Mthanson1/bomu-ieee-sscs/docs/main.pdf

# BoMu: A Resistively-Loaded NMOS Differential Pair Design & Sizing (SKY130A, TinyTapeout)

Mathew Hanson

October 2026

## 1 Introduction

BoMu is a single-stage differential amplifier built from a resistively-loaded NMOS source-coupled pair, designed for the SKY130A PDK and open-source TinyTapeout flow. Two matched NMOS devices (M1, M2) share a tail sink of 2ID, and each drain is pulled to the 1.2V supply through a load resistor RD. The amplifier output is taken differentially across the drains, vod = v(voutp) − v(voutn). A floating differential source ±vsd/2 on a common-mode VSC drives the gates through 100Ω series resistors.
The driving bandwidth constraint is that each output drives an I/O pad of fixed CL = 5pF. The tail sink is realised on-chip as a simple current mirror (Section 8.8) with a 200mV compliance budget. The flow is fully open-source (xschem, ngspice, magic/klayout); devices are sized by a gm/ID methodology [1] from measured current-density and speed data rather than an assumed square-law constant, and the small-signal results are standard [2].
This report documents the adopted W = 80 µm design and signs it off at the tt corner (with the native device-mismatch Monte Carlo of Section 10). The design is placed explicitly on the gm/ID area–power trade (Sections 8.3–8.4), where it sits at the optimum of a power-weighted cost. The common-centroid magic layout is then drawn, closed LVS/DRC clean, and re-simulated against its extracted parasitics (Section 11), which confirms both targets survive the layout.

### 1.1 Net identities

With the sign convention M1 gate = vinp → drain = voutn, and M2 gate = vinn → drain = voutp, the differential output vod = v(voutp) − v(voutn) has positive gain with respect to the differential input vid = vinp − vinn. The two half-circuits are identical by matching, so the analysis is done on a single common-source half-circuit and the differential result follows directly.

## 2 Specifications

The target specifications, and recommended design parameters, are collected in Table 1.

Table 1: Design targets and recommended parameters.
Parameter | Value | Units
Small-signal bandwidth f−3dB | 150 | MHz
Differential DC gain Av0 | 10 | dB
Differential output swing vod | 400 | mVpp
Channel length L | 0.15 | µm
Supply VDD | 1.2 | V (fixed)
Pad load CL (each output) | 5 | pF (fixed)
Tail-sink compliance budget | 200 | mV (fixed)

## 3 First-Order Hand Design

The design proceeds as follows: the fixed pad capacitance and the bandwidth target set the load resistor, the gain target then sets the required transconductance, and a chosen inversion level (gm/ID) fixes the

bias current.

Load resistor from bandwidth. The dominant pole sits at the output node, formed by the load resistance working into the fixed CL. Ignoring the device output resistance for the moment,

RD =

1
2πf−3dBCL

=

1
2π(150MHz)(5pF) ≈ 212Ω. | (1)

Transconductance from gain. The differential (half-circuit) gain of a resistively-loaded pair is

Av0 = gm(RD∥ro)

ro≫RD −−−−−−→ gmRD. | (2)

With Av0 = 10dB = 3.162V/V and Eq. (1),

gm =

Av0
RD

=

3.162
212Ω ≈ 14.9mS. | (3)

Bias current from gm/ID. Choosing a moderate-inversion gm/ID = 15V⁻¹
(a balance of device area, ro, and speed at this minimum length) fixes the per-branch current and the tail current,

ID =

gm
(gm/ID)

=

14.9 mS
15
≈ 0.99mA, | Itail = 2ID ≈ 2mA. | (4)

Swing and headroom. A 400mVpp differential swing corresponds to a single-ended peak of vod/4 = 100mV about each drain’s DC level VD = VDD − IDRD ≈ 0.99 V . Two conditions must hold: the bias drop must be large enough to source the swing, IDRD > 100mV (IDRD ≈ 210mV is ample), and the device must remain saturated at the bottom of the swing, VD,min − (VS + Vov) > 0, where VS is the tail-node voltage held at or above the 200 mV compliance budget. Both are comfortably satisfied because RD is small and the supply headroom is large.

## 4 gm/ID Sizing Flow

Equations (1)–(3) fix RD and the required gm. The gm/ID method then turns the chosen inversion level into a physical width. A unit device is characterised over VGS at fixed (VSB, VDS) to build a lookup grid returning, for any gm/ID, the current density JD (=ID/W), the intrinsic gain gmro, and the transit frequency fT . The width then follows as

W =

ID
JD(gm/ID, VSB, VDS)
| . | (5)

This is implemented in sim/sizing.py (worksheet), which references the extern/sky130A-gmid lookup grid (a git submodule). The script takes a DESIGN dict (targets + the two free knobs, gm/ID and VS), prints the worksheet of Table 2, and with --spice generates a differential-pair deck, runs ngspice, and reports predicted-versus-SPICE side by side (Table 3).

Table 2: Sizing worksheet at example operating point (gm/ID = 15, VS = 0.30 V , L = 0.15 µm, SKY130A nfet 01v8 lvt).
Quantity | Value | Units
RD (from BW) | 212 | Ω
gm required (from gain) | 14.9 | mS
ID / Itail | 0.99 / 1.99 | mA
Vov = 2/(gm/ID) | 0.133 | V
current density JD | 14.6 | µA/µm
width W (per device) | 68.0 | µm
output resistance ro | 941 | Ω
intrinsic gain gmro | 14.0 | —
transit frequency fT | 51.3 | GHz
bias nodes VD / VDS | 0.989 / 0.689 | V
power VDD ·Itail | 2.38 | mW

## 5 The ro-Limited Gain

Equation (2) assumed ro ≫ RD, but at minimum length this does not hold. The lookup returns ro ≈ 941Ω at gm/ID = 15, so the effective load is

RL = RD∥ro = 212∥941 ≈ 173Ω, | (6)

and the realised gain and bandwidth become

Av0 = gmRL ≈ 2.58 V/V (8.23dB), f−3dB =

1
2πRLCL
≈ 184MHz. | (7)

Because RD is pinned at 212 Ω by the fixed CL and the bandwidth target (Eq. (1)), and ro at this length is comparable to RD, the gain + BW targets are competing: the finite ro pulls the gain down to ∼ 8.2dB while pushing the bandwidth up past 150MHz. A single resistively-loaded stage at L = 0.15µm cannot simultaneously meet 10dB and 150MHz for the selected RD at the baseline current.
Figure 1 shows this: sweeping the inversion level with gm held at the gain-target value (14.9 mS), the realised gain plateaus near 8.3dB and never reaches 10 dB. At L = 0.15 µm the intrinsic gmro is simply too small for ro to dominate RD, regardless of bias. The resolution (Section 8.6) is a small increase in gm — i.e. a little more current — which lifts the realised gain–bandwidth product enough to clear both targets.


Figure 1: Gain and bandwidth versus inversion level gm/ID, with gm fixed at 14.9mS and RD = 212Ω. The gain plateaus near 8.3dB.

## 6 SPICE Verification (SKY130A, tt corner)

The self-contained differential AC testbench sim/tb ac.spice (floating ±vsd/2 drive, 100Ω gate resistors, on-chip 2ID tail mirror, 5pF pad caps) exercises the design under ngspice with the SKY130A tt models. The hand-calculations track SPICE closely as shown in Table 3. Particularly, the RD∥ro gain estimate of Section 5 reproduces the simulated gain to within 0.01dB, confirming the ro-limited result is real.

Table 3: Predicted (hand-calc) versus SPICE at the baseline sized operating point (W = 68µm, gm/ID = 15).
Quantity | Predicted | SPICE | Units
Tail current Itail | 1987 | 1987 | µA
gm per device | 14.9 | 14.85 | mS
Tail-node voltage VS | 0.30 | 0.205 | V
Differential gain Av0 | 8.23 | 8.24 | dB
Bandwidth f−3dB | 183.8 | 177.8 | MHz

The simulated response (Figure 2) is a flat ∼ 8.2dB passband rolling off at the single output pole, below the 10dB gain target and above the 150MHz bandwidth target — the ro-limited baseline that the gainrecovery of Section 8.6 corrects. The one row that does not track is the tail-node voltage VS (0.30V predicted vs. 0.205V in SPICE). This is expected: the 0.30V is not a prediction but the input knob fed to the gm/ID grid — the assumed source/body bias VSB at which the unit device was characterised (Table 2) — whereas the realised tail node is set by the input common mode and the pair’s actual VGS, and settles at 205mV (just above the 200mV compliance budget). The ∼ 95mV gap does not propagate into the sizing because W is taken from the current density JD, which depends only weakly on VSB; this is why gm, gain and bandwidth still match to within a percent despite it. The drain DC operating point of 0.988V matches VDD − IDRD exactly.


Figure 2: Differential AC response from sim/tb ac.spice (SKY130A, tt, baseline W = 68µm).

## 7 Design Bookkeeping: Predicted vs. SPICE Across the Flow

Table 3 spot-checked five quantities; this section carries the entire gm/ID sizing flow as a single Murmannstyle design-cockpit table (Table 4), each row quoting the hand/grid prediction against SPICE with a percentage error, at the baseline W = 68µm sizing point the method produces. The table is generated directly by sim/sizing.py cockpit (console) and --latex (this tabular), so it stays in sync with the sizing script. Of the sixteen rows carried predicted-vs-SPICE the mean absolute error is 1.1% and the worst is 6.5%.

Table 4: Design-cockpit bookkeeping at the baseline sized operating point (W = 68µm, gm/ID = 15, tt, 1.2V , 27◦C). Generated by sim/sizing.py cockpit --latex.

Parameter | gm/ID pred. | SPICE | %err | note
RD [Ω] | 212.2 | – | – | set by BW & C L (ideal load)
gm/ID [1/V] | 15 | 14.95 | -0.3 | inversion level (chosen)
ID/branch [µA] | 993.5 | 993.5 | +0.0 | gm req/(gm/Id)
Itail [mA] | 1.987 | 1.987 | +0.0 | = 2*Id (VDD current)
Vov [mV] | 133.3 | 142 | +6.5 | 2/(gm/Id) vs Vgs-Vth
JD [µA/µm] | 14.61 | 14.61 | +0.0 | current density (grid)
W [µm] | 68.02 | – | – | = Id/Jd (then rounded)
gm/device [mS] | 14.9 | 14.85 | -0.3 | = Av0/R D (ideal)
ro [kΩ] | 0.9415 | 0.9598 | +1.9 | output resistance
gmro [V/V] | 14.03 | 14.25 | +1.6 | intrinsic gain
fT [GHz] | 51.32 | 51.03 | -0.6 | = gm/(2pi.Cgg)
Cgg [fF] | 46.21 | 46.32 | +0.2 | gate cap
RL=RD∥ro [Ω] | 173.2 | 173.8 | +0.4 | real load
Av0 [dB] | 8.234 | 8.235 | +0.0 | = gm.R L
f−3dB [MHz] | 183.8 | 177.8 | -3.3 | = 1/(2pi.R L.C L)
GBW [MHz] | 474.3 | 458.9 | -3.2 | gain-bandwidth
Ptot [mW] | 2.384 | 2.384 | +0.0 | = VDD.I tail
VD (drain) [V] | 0.9892 | 0.9892 | -0.0 | drain DC
Vtail [V] | – | 0.2047 | – | ideal tail src; ≥0.2 V compliance met
SE swing peak [mV] | 100 | – | – | = v od/4 (headroom check)

The table shows two things. The current-domain rows (the grid density JD, hence W, and ID, gm, fT , Cgg, ro, gmro) all land inside 2%: the gm/ID grid predicts the sized device from the targets with essentially no iteration. The one visible gap is Vov (+6.5%): the Vov ≈ 2/(gm/ID) rule-of-thumb underestimates the true overdrive in moderate inversion, but because W is taken from the grid current density JD (not from Vov), that approximation does not propagate into the sizing. The cockpit is carried at W = 68µm rather than the adopted W = 80µm deliberately: this is the point the sizing flow produces directly from the targets, with no hand adjustment, so the predicted-vs-SPICE error isolates the accuracy of the gm/ID grid itself. The adopted design differs only by the deliberate GBW-wall and parasitic current margin of Sections 8.6–8.7 (and a re-centred RD), which are design choices, not predictions; rerunning the cockpit there would reproduce the same current-domain errors — the grid accuracy is independent of the sizing point — offset by that known margin, so it would add nothing about the method. The output rows then confirm the baseline sits where the flow places it — Av0 = 8.2 dB and f−3dB = 184 MHz — i.e. comfortably past the bandwidth target but short of the 10 dB gain, the ro-limited shortfall of Section 5 that the small gm increase of Section 8.6 then recovers to reach the adopted W = 80µm design.

## 8 Design-Space Sweeps and the Gain–Bandwidth Limit

Section 5 showed that at the chosen RD = 212Ω, the finite ro leaves the gain short and the bandwidth long. This section sweeps RD and L to map the achievable space.

### 8.1 RD: trading gain for bandwidth at constant gm/(2πCL)

For a single output pole the gain–bandwidth product is

Av0 · f−3dB = gm(RD∥ro) ·

1
2π(RD∥ro)CL

=

gm
2πCL
, | (8)

With gm = 14.9mS and CL = 5pF this ideal product is 474MHz. Sweeping RD (Figure 3) therefore slides the design along this fixed hyperbola. A larger RD buys gain at the cost of bandwidth. This sweep is at constant power, since RD draws no bias current. It is also, by itself, not a route to the gain target: once the two targets pin the product, no RD clears both at the baseline gm (quantified in Section 8.5).


Figure 3: RD sweep (iso-power 2.38mW): gain rises and bandwidth falls along the constant gm/(2πCL) product. Dotted lines mark the 10dB and 150MHz targets.

Channel length was also swept in an attempt to recover additional gain. Longer L raises ro, so RD∥ro → RD and the gain climbs toward the ideal gmRD at constant power (the current is unchanged, W ∝ L to hold the inversion level). The recovery is modest and saturating: 8.2dB at L = 0.15µm up to only ≈ 9.1dB by L = 0.6µm, which was still short of the 10dB target confirming the ro-limited ceiling of Section 5. Length trades area for a fraction of the missing gain but does not, on its own, reach the target.

### 8.2 The design space: bandwidth versus power at fixed gain and swing

The RD sweep moved along one iso-power hyperbola; the next question is how much bandwidth is available once power is allowed to vary, subject to the fixed 10dB gain and 400mV pp swing. For the single output pole, eliminating the load between Av0 = gm(RD∥ro) and f−3dB = 1/(2π(RD∥ro)CL) gives the load-independent relation

f−3dB =

gm
2πAv0CL

=

(gm/ID) ID
2πAv0CL
, | (9)

so at fixed Av0 and the fixed 5pF pad the bandwidth is set only by gm. Since P = VDD Itail = 2VDDID, bandwidth therefore scales linearly with power, and the slope of that line is the gm/ID efficiency. Figure 4 maps this plane: each line is one inversion level, swept over current.


Figure 4: Design-space frontier: achievable f−3dB versus power at fixed 10dB gain and 400mV pp swing, one line per gm/ID (slope ∝ gm/ID). Dashed segments are infeasible; the gold star is the adopted W = 80µm design on the gm/ID = 15 ray (2.74mW, 10.1dB, 168MHz).

Note first that feasibility is essentially current-independent: the headroom and swing walls are conditions on gm/ID, not on power, so each inversion level is feasible (or not) across the whole power axis. The nominal feasible window is wide, gm/ID ≈ 9 to 41: below ≈ 9 the drain headroom fails (the overdrive is large and, with gmro low, the gain-setting RD grows large enough to collapse the drain), and above ≈ 41 the RD drop falls below the 100mV single-ended swing. Within that window the only way to raise bandwidth at fixed power is to raise gm/ID: at the 2.38mW baseline, moving from gm/ID = 15 (150MHz) up toward the swing wall would, on paper, reach ∼ 380MHz at the same power.
That wide window is misleading, though. BoMu holds a moderate gm/ID = 15 (Vov ≈ 130mV ) rather than chasing the swing wall for robustness: a higher gm/ID means a smaller Vov and less gmro margin, so the stage becomes progressively more sensitive to the device spread the sizing is supposed to tolerate, and the moderate inversion keeps that headroom. The practical lever for more bandwidth is therefore power (the slope of Eq. (9)), not a freer inversion level — and, symmetrically, the only way to cut power at these specs is to cut gm, which gives back bandwidth one-for-one.

Where the design sits, and the minimum it costs. Figure 5 recasts the same plane with gain on the vertical axis, which makes the hard-target minimum explicit. With 150MHz pinning the load at RL ≤ 212Ω, the gain at the bandwidth edge is Av0 = gmRL = (gm/ID) ID · 212Ω, so each inversion level is a ray rising with power (slope ∝ gm/ID) until it saturates at the gmro ceiling. The power at which a ray crosses 10dB is the ideal minimum to meet both targets at that gm/ID — ideal because it assumes the realised gain–bandwidth product equals the single-pole gm/(2πCL) of Eq. (8). On the gm/ID = 15 ray adopted here that ideal floor is 2.38mW. It is not reachable in practice: as Section 8.5 shows, second-order gate/Miller poles pull the realised product ∼ 1.5% short, so the baseline at this power misses both targets by a few percent. The adopted W = 80µm design therefore sits above the ideal floor at 2.74mW once that gain-bandwidth-wall and the parasitic margin (Sections 8.6–8.7) are added. Spending more power moves the design up its ray (more gain/BW margin) and spending less moves it down toward the infeasible region — the adopted point is a deliberately small step above the ideal floor.

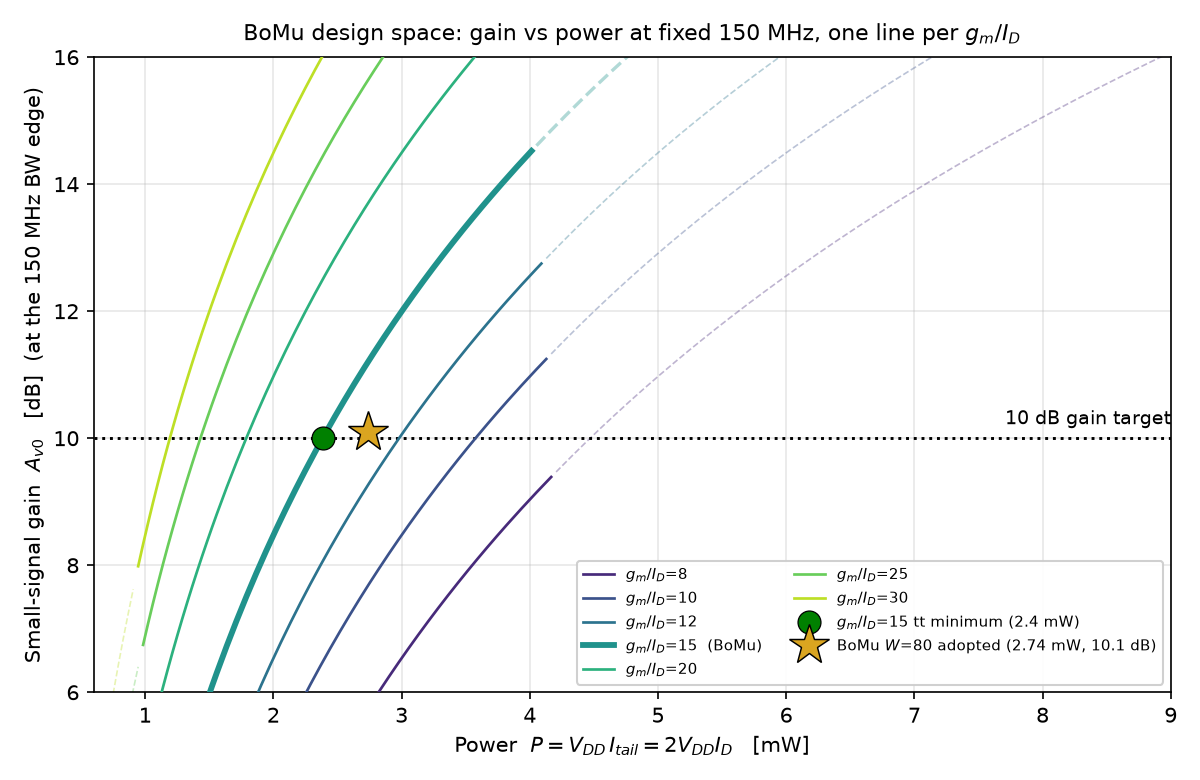
[picture p9: figure]

Figure 5: Gain versus power at the fixed 150MHz edge, one line per gm/ID. On the gm/ID = 15 ray the 10dB target has an ideal (single-pole) floor of 2.38mW (green circle); the realised design clears both targets a step above it, at the adopted W = 80µm point (2.74mW). Generated by sim/plot gain space.py.

### 8.3 The area–power plane: where each gm/ID ray sits

The bandwidth- and gain-versus-power views priced each inversion level in power ; the third axis that matters on a fixed TinyTapeout tile is area. This subsection adds it, so the inversion level can be chosen on the full area–power trade before the operating current on the ray is fixed (Sections 8.5–8.7).
Figure 6 projects the 10dB/150MHz tt criteria onto the area–power plane, one ray per inversion level, in the same house style as the bandwidth- and gain-versus-power frontiers of Section 8.2. At fixed gm/ID the pair gate area is linear in power,

2W L = 2L

ID
JD

=

L

VDD

P
JD(gm/ID)
, | (10)

so each gm/ID is a ray from the origin whose slope ∝ 1/JD steepens with inversion level (weak inversion spends area fast). The 10dB/150MHz spec needs a minimum gm, hence a minimum current, so each ray is spec-feasible only above an onset power (solid above, dashed below); the locus of those onsets is the tt frontier. Along it, strong inversion (low gm/ID) gives small area but high power, weak inversion the reverse — area and power trade against each other, bounded below by the drain-headroom wall and above by the output-swing wall of Section 8.2.


Figure 6: Area–power plane: pair gate area 2W L versus power to meet 10dB/150MHz at tt, one ray per gm/ID (solid where spec-feasible, dashed below the onset marker). The adopted W = 80µm design (gold star, 2.74mW, 24µm²
) sits on the gm/ID = 15 ray, just above its ideal (single-pole) onset minimum (green circle, 2.38mW, 21µm²
). Generated by sim/plot area power.py.

The eventual operating point (gold star — the W = 80µm design fixed in Sections 8.6–8.7) will sit at the lower-left of this plane, near the minimum area and minimum power the tt criteria allow at a conservative moderate inversion, on the gm/ID = 15 ray, a small step above its feasibility onset. Whether gm/ID = 15 is itself the right ray to be on is settled in the next subsection with a scalar cost.

### 8.4 The gm/ID optimum: a power-weighted cost

Each gm/ID ray in Figure 6 meets the spec at a different (area, power) pair, so choosing the inversion level is choosing a point on the area–power frontier. To collapse that two-dimensional trade to a single preference we score each feasible ray with a scalar cost and ask which gm/ID minimises it (Figure 7).

Equal weighting is nearly flat. The scale-free equal-weight product Pmin ·A gives the shallow grey bowl of Figure 7, minimised at gm/ID ≈ 12 but very weakly defined (the band gm/ID ≈ 10–15 is within +10%). The flatness is structural: near the square-law limit JD ∝ V

2
ov and gm/ID ∝ 1/Vov,
so P ·A ∝ 1/
(gm/ID)

2JD

is nearly constant — power and area trade almost reciprocally, and their product barely discriminates. The tilt that remains comes from the ro-gain wall inflating power below the bowl and JD collapsing (area diverging) above it.

Power-weighting selects gm/ID = 15. Equal weighting is the wrong model here: it prices a µm² and a mW the same, whereas on a fixed TinyTapeout tile area is effectively free and power is the real budget. Valuing power roughly twice the area — the scale-free weighted product C = P

0.66A⁰.33 — pulls
the optimum up in gm/ID (toward lower power), from 12 to ≈ 15 (black curve). The same shift lands at gm/ID = 15.0 under a normalised weighted sum 0.66 Pˆ + 0.33 Aˆ, so the result is not an artifact of the sum-versus-product choice. BoMu’s gm/ID = 15 is therefore the optimum of this power-weighted cost, and the adopted W = 80µm design sits on that ray.

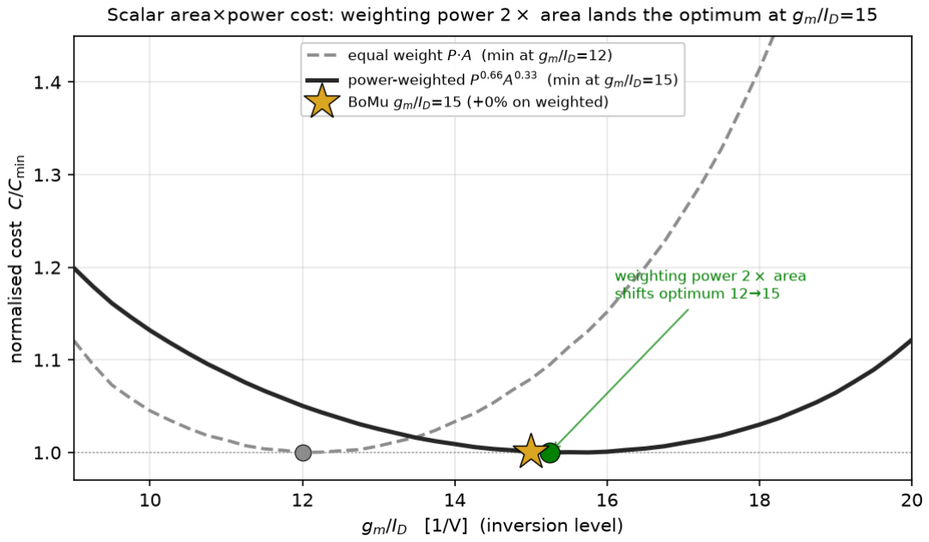
[picture p10: figure]

Figure 7: Scalar cost of the area–power trade along the tt frontier, each curve normalised to its own minimum. Equal weight P·A (grey dashed) minimises at gm/ID ≈ 12; power-weighted P

0.66A⁰.33 (black)
shifts the optimum to gm/ID ≈ 15, BoMu’s choice (star). Generated by sim/plot area power.py.

Two qualifications are worth stating. The 0.66/0.33 weights are a design choice (power-limited tile), not a derivation; a different valuation moves the optimum, and the bowl is shallow enough that anything in gm/ID ≈ 13–17 is near-equivalent, so the cost function corroborates gm/ID = 15 under a reasonable power-first weighting rather than uniquely forcing it. Independently, a moderate gm/ID also carries the larger Vov and gmro headroom that makes the stage tolerant of device spread (Section 8.2), so the power-weighted cost optimum and the robustness-preferred value coincide at 15.

### 8.5 Sizing the current on the ray: is RD ≈ 280 Ω enough?

With gm/ID = 15 fixed as the cost-optimal ray, the remaining freedom is the operating current on it. The baseline sizing (Section 6: W = 68µm, Itail = 1.99mA) sits at the bottom of that ray; this subsection confirms it cannot reach both targets by re-tuning RD alone, which motivates the small current increase of Section 8.6. The two targets have product 3.162×150MHz = 474MHz, which is exactly the ideal GBW of Eq. (8). The specification therefore sits right on the single-stage limit, reachable only if the realised product equals the ideal. It does not: second-order gate/Miller poles pull the SPICE gain–bandwidth product down to ≈ 467MHz, about 1.5% short. Table 5 brackets RD in SPICE (tt, L = 0.15, W = 68); note no value of RD has sufficient GBW product at the baseline gm.

Table 5: RD bracket in SPICE.
RD [Ω] | Av0 [dB] | f−3dB [MHz] | GBW [MHz]
220 | 8.49 | 175.8 | 468
250 | 9.37 | 158.7 | 467
265 | 9.76 | 151.7 | 467
280 | 10.13 | 145.4 | 467
300 | 10.58 | 137.9 | 466

So RD ≈ 280Ω is a close but still not a feasible solution: the gain passes (10.13dB) but the bandwidth is 145MHz (∼ 3% low). Moving to RD = 265Ω recovers bandwidth to 152MHz but drops the gain to 9.76dB. The Av0 = 10dB crossover lands at RD ≈ 277Ω with only f−3dB ≈ 148MHz. The design lands within ∼ 2–3% of both but meets neither pair simultaneously, with no margin. Closing the last few percent requires more GBW, which Eq. (8) says comes from a slightly higher gm (a little more current/power).

### 8.6 Meeting both specs: a small gm increase

Because the realised GBW scales with gm (Eq. (8)), the ∼ 1.5% shortfall is closed by a comparably small increase in gm. Holding gm/ID = 15 and L = 0.15µm, raising gm from 14.9 to 16.0mS (widening the pair and the tail current) lifts the realised gain–bandwidth product to ≈ 500MHz, clearing the 474MHz the pair requires. Re-centring the load then lands both targets with margin (Table 6).

Table 6: Closing the GBW gap with a gm increase, SPICE tt, L = 0.15µm, gm/ID = 15 (ideal tail sink).
gm [mS] | W [µm] | RD [Ω] | Av0 [dB] | f−3dB [MHz] | P [mW]
14.9 (base) | 68 | 212 | 8.24 | 178.0 | 2.38
15.6 | 71 | 272 | 10.23 | 150.2 | 2.50
16.0 | 73 | 262 | 10.15 | 155.5 | 2.56
16.0 | 73 | 272 | 10.40 | 151.1 | 2.56

The rows above cross the targets near gm = 16mS (W ≈ 73µm), but the margins there (+0.15dB, +5.5MHz) are thin. A small additional current buys headroom against the layout parasitics that Section 8.7 addresses, fixing the final operating point.

### 8.7 Layout-parasitic headroom and the adopted operating point

The gm ≈16mS point only marginally clears the bandwidth target, and layout will add output-node capacitance (drain-junction Cdb plus pad interconnect) on top of the fixed 5pF. Since f−3dB = 1/(2πRLCtot) falls with total capacitance while the DC gain gmRL is unaffected (a capacitance is an open circuit at DC and carries no bias current), only the bandwidth spec is exposed to parasitics. The remedy is a small current margin: widening the pair to W = 80µm (Itail = 2.28mA) on the RD ≈ 245Ω load lifts the nominal bandwidth well past target with the gain comfortably over 10dB. At this point the measured response (real res high po loads and mirror, tt) is

Av0 = 10.1 dB, | f−3dB = 168 MHz, | P = 2.74 mW, | (11)

so the bandwidth carries ∼ 12% of headroom over 150MHz — enough to absorb the few-percent capacitive pole shift a compact layout adds while the gain, which parasitics do not touch, holds its ∼ 0.1dB margin. This is the adopted design; its sizing is summarised in Table 7.

Table 7: Adopted W = 80µm sizing (ip/bomu.sch).
Device | Sizing | Role
M1, M2 (pair) | nfet 01v8 lvt W=80 µm, L=0.15, nf=8 | input diff pair
RD1, RD2 | res high po 5p73 L=3.1 µm (≈ 243 Ω) | drain loads
M3 (mirror out) | nfet 01v8 W=80 µm, L=0.5, nf=8 | tail sink (N=8)
M4 (mirror ref) | nfet 01v8 W=10 µm, L=0.5, nf=1 | diode reference
Rref | res high po 2p85 L=5.41 µm (≈ 745 Ω) | Itail program
Itail | 2.28 mA (VSC = 1.052 V ) | —

### 8.8 Tail-current mirror and input common-mode

The ideal tail sink is realised on-chip as a simple two-transistor resistor-programmed NMOS mirror, kept fully internal. A cascode/Wilson mirror needs VGS + VDS,sat ≳ 0.5V of compliance, far above the tail budget, so only a simple mirror fits. A raised input common-mode VSC = 1.052V lifts the tail node to ≈ 0.33V , putting the mirror in clean saturation while the pair retains abundant drain headroom. The 400mVpp swing survives (lowest single-ended output 0.82V , still well above the saturation floor; Section 9).
The mirror uses standard-VT nfet 01v8 devices at L = 0.5µm: output M3 = W80µm/nf8, reference M4 = W10µm/nf1, ratio N = 8, so the reference leg draws only Itail/8 ≈ 0.285mA through Rref ≈ 745Ω from VDD. An integrated AC simulation (sim/tb ac.spice) with the real mirror replacing the ideal sink closes the operating point and leaves the differential spec essentially untouched (Table 8): at Rref = 745Ω the tail settles at 0.333V , Itail = 2.28mA, Av0 = 10.19dB, f−3dB = 167MHz (ideal RD; the real res high po load trims this to the 10.1dB/168MHz of Section 8.7). The gain degrades by only ∼ 0.03dB from the ideal source, as the mirror’s finite rout lands on the common-mode path, not the differential one. The programming resistor sets Itail, so Rref is the single knob for the gain/BW trim. The mirror is folded into ip/bomu.sch (M3/M4, Rref ); the complete schematic — pair, dummy-flanked loads and tail mirror — is shown in Figure 8.

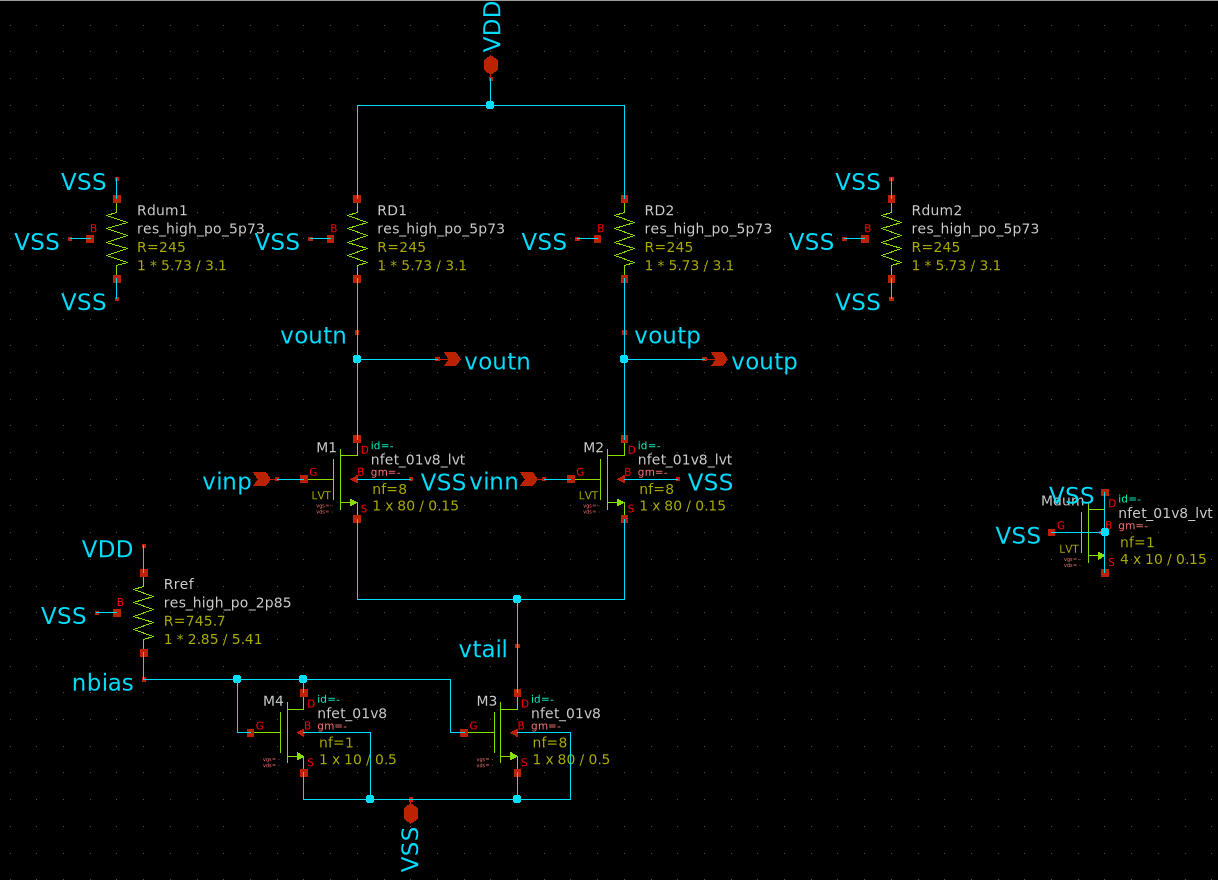
[picture p11: figure]

Figure 8: The adopted W = 80µm BoMu schematic ip/bomu.sch: M1/M2 pair, res high po drain loads RD1/RD2, and the resistor-programmed N=8 tail mirror (M3/M4, Rref ).

Table 8: Integrated AC verification (sim/tb ac.spice): BoMu with the real tail mirror (Wout = 80, Wref = 10, L = 0.5, N = 8), sweeping the programming resistor. W = 80µm pair, ideal RD = 245Ω, VSC = 1.052V .

Rref [Ω] | Vtail [V] | Itail [mA] | Av0 [dB] | f−3dB [MHz]
720 | 0.332 | 2.32 | 10.26 | 167.8
745 | 0.333 | 2.28 | 10.19 | 167.3
760 | 0.334 | 2.26 | 10.15 | 167.1

## 9 Large-Signal Swing and Distortion

The 400mVpp differential output swing (Table 1) is a large-signal requirement, so it is checked with a dedicated transient testbench (ip/tb bomu swing.sch, Figure 9, which instantiates the bomu.sym symbol hierarchically). A differential 1MHz sine rides on the VSC = 1.052V input common mode with persource amplitude Va = 32mV , so vid,pp = 4Va = 128mVpp drives the amplifier to the swing target. At the tt corner (1.2V , 27◦C) the measured swing is vod,pp = 400mVpp, on target, with each single-ended output spanning 0.824–1.024V about a ∼ 0.924V common mode — inside the rails with every device still saturated, so the stage is not clipping. The same deck reports the AC gain/bandwidth and the averaged supply power (Av0 = 10.1dB, f−3dB = 168MHz, 2.74mW pair / 3.10mW total including the reference leg), so swing, gain, bandwidth and power all come from one run.


Figure 9: The transient swing testbench ip/tb bomu swing.sch.

Third-harmonic dominance. A Fourier decomposition of vod (fundamental 1MHz, ten harmonics) gives THD = 0.61%, set almost entirely by the third harmonic (Table 9). Two features are characteristic of a balanced source-coupled pair. First, the even harmonics vanish (at the ∼ 10⁻¹⁴ numerical floor): even-order distortion is common-mode and cancels in vod = v(voutp)−v(voutn), so their absence confirms the devices and loads are symmetric. Second, the residual distortion is odd-order, led by the third. Both features follow from the shape of the balanced pair’s differential transfer iod(vid), independently of any particular device law: it is an odd function of the differential drive (swapping the inputs negates the output), which is precisely what forces the even harmonics to cancel, and it is compressive (the pair steers a fixed tail current, so iod saturates at ±Itail). An odd, compressive characteristic has a Taylor expansion in odd powers of vid alone, so the leading nonlinearity is the cubic term,¹ which folds back as a third harmonic. The fifth and higher harmonics fall off by orders of magnitude, hence THD ≈ the third-harmonic term alone. Because that term scales with the cube of the drive, distortion climbs quickly

1There is no closed-form expression for iod(vid) at BoMu’s operating point. The often-quoted iod ∝ tanh
vid/2nVT
is the weak-inversion limit only, where the devices follow the exponential law iD ∝ exp(vGS/nVT ) (VT = kT /q the thermal voltage, n the subthreshold slope factor, highest gm/ID); the opposite strong-inversion limit is the square-law
√
-characteristic. BoMu runs at gm/ID ≈ 15 (moderate inversion), between the two, where neither closed form holds — but the odd-symmetry and leading-cubic arguments above hold throughout.

with swing; at the 400mVpp operating point it stays a clean 0.61%.

Table 9: Fourier spectrum of vod at the 400mVpp operating point (tt, 1.2V , 27◦C, 1MHz drive).
Harmonic | Freq [MHz] | Norm. mag
1 | 1 | 1.000 | fundamental (0.201 V ampl.)
2 | 2 | 4 × 10⁻¹⁴ | even (cancelled)
3 | 3 | 6.1 × 10⁻³ | dominant (≈ THD)
4 | 4 | 5 × 10⁻¹⁴ | even (cancelled)
5 | 5 | 7.0 × 10⁻⁶

## 10 Small-Signal Quality: Offset, CMRR, PSRR and Noise

Beyond the headline gain/bandwidth/swing targets, the pair is characterized for input offset, common-mode and supply rejection, and noise, at tt/1.20V / 27◦C. These figures are measured on the extracted, post-layout netlist (verify/bomu rcx.spice, full R + C RCX of the signed-off W=80µm layout) via sim/corners.py acq rcx and sim/corners.py mc mm --pex rcx, so the numbers below carry the real device sizing and the layout parasitics. One point about the models frames every mismatch-dependent number. Contrary to a common belief about the open PDK, sky130A does carry native statistical device mismatch: the .pm3 model cards apply per-device Gaussian spread to Vth0, toxe, vof f and nfactor through mc mm switch·AGAUSS(. . .) terms, live in nfet 01v8 lvt (the pair), nfet 01v8 (the mirror) and res high po (the loads). Because the extracted .subckt wraps these same sky130 device instances, the native mismatch still redraws per device inside the parasitic netlist. The offset below is therefore drawn from this native mismatch with no assumed Pelgrom coefficient (mc mm switch flipped via alterparam after the .lib loads, then re-seeded per draw; see corners.py mc mm --pex).

Input offset. A 40-draw native-mismatch Monte Carlo on the extracted W=80µm pair (12µm² per device) gives σ(Vos) ≈ 2.8mV (3σ ≈ 8.3mV , worst draw 7.4mV ), centred on zero (mean +0.6mV ). Because offset grows as 1/

√
W L, this is set by the pair size the gain–bandwidth sizing already demands; it is modest by construction and protected by the common-centroid layout of Section 11 — indeed the extracted interdigitated pair sits a little below the ∼ 3.6mV a single lumped W=80µm device predicts. Offset is treated as a separate, un-targeted spec here.

CMRR and PSRR. Because the output is taken differentially between matched halves, common-mode input and supply ripple couple almost entirely into the output common mode and cancel differentially. The differential CMRR and PSRR are matching-limited, not tail-limited, and would be infinite for a perfectly symmetric netlist; over the native-mismatch draws on the extracted netlist their median is CMRR ≈ 67dB and PSRR ≈ 53dB (both scale inversely with the per-draw mismatch, so they are quoted as the median of the 24-draw set). The underlying common-mode paths set the ceiling and are finite: the tail-limited common-mode gain is Acc = −17.6dB, and because RD couples VDD straight onto each drain — now reinforced by the asymmetric VDD-to-drain coupling capacitors the extraction adds — the supply-to-common gain rises to Asc = −7.8dB. This is the same balance that suppressed the even harmonics in Section 9.

Noise. The input-referred noise of the extracted netlist integrated over 10Hz–1GHz is ≈ 93µVrms (device thermal/flicker dominated, so it is taken at the nominal matched point rather than per mismatch draw). Against the ∼ 45mVrms differential input drive that produces the 400mVpp output swing (the vid,pp = 4Va = 128mVpp at Va = 32mV of Section 9), this is an input SNR of order 54dB. The integration band runs well past the ∼ 164MHz output pole, so the figure is conservative: above the pole the falling gain inflates the input-referred density, and most of the integral accumulates beyond the usable band.

Table 10: Post-layout small-signal quality on the extracted netlist (verify/bomu rcx.spice) at tt/1.20V /27◦C. Input offset is a 40-draw native sky130A device-mismatch Monte Carlo (no assumed AV T ); the differential CMRR/PSRR are mismatch-limited and quoted as the median of a 24-draw set (they scale inversely with the per-draw mismatch). Noise is at the nominal matched point.
Metric | Value | Condition
Input offset σ(Vos) | ≈ 2.8 mV | native-mismatch MC (40 draws)
Input offset 3σ | ≈ 8.3 mV | native-mismatch MC (40 draws)
CMRR (differential) | ≈ 67 dB | native mismatch (median, 24 draws)
PSRR (differential) | ≈ 53 dB | native mismatch (median, 24 draws)
Common-mode gain Acc | −17.6 dB | tail-limited
Supply→CM gain Asc | −7.8 dB | RD + parasitic coupling
Input-referred noise | ≈ 93µVrms | 10Hz–1GHz, nominal

## 11 Physical Layout in magic

With the W = 80µm design signed off against the tt corner, the bomu cell is drawn in magic on SKY130A from the adopted schematic (Table 7), following the matching and isolation methodology below.

Pair core. The overriding layout concern for a differential pair is matching of M1/M2, so the core is a common-centroid interdigitation of the nf = 8 pair. The W = 80µm/nf = 8 pair lays out as 10µm-per-finger unit devices on isolated diffusion islands, assigned to the two halves in an alternating centroid pattern so a linear process gradient across the block cancels differentially.

Edge dummies. Matching is protected at the array edges by same-width nf = 1 dummy transistors on the left and right columns, which give the outermost live fingers an identical poly/diffusion neighbourhood (10µm finger width, matching the pair). Their gates, sources and drains are strapped to VSS. The load resistors are handled the same way: the two live loads RD1/RD2 (res high po 5p73) are flanked by two dummy resistors of identical geometry for etch/density symmetry, terminated to VSS.

Tail mirror and guard rings. The mirror lays out as a single interdigitated row of nfet 01v8 unit fingers (W = 10µm, L = 0.5µm) with the diode-connected reference M4 at the centre and the eight M3 output fingers around it (a 1-D common-centroid, ratio N = 8); the programming resistor Rref (res high po 2p85) sits beside it. Being an all-NMOS block, every sub-block is wrapped in a p⁺ guard ring tied to VSS with no n-well, and the six top-level ports (vinp, vinn, voutp, voutn, VDD, VSS) are brought out on upper metal past the outer ring. The finished cell is shown in Figure 10.

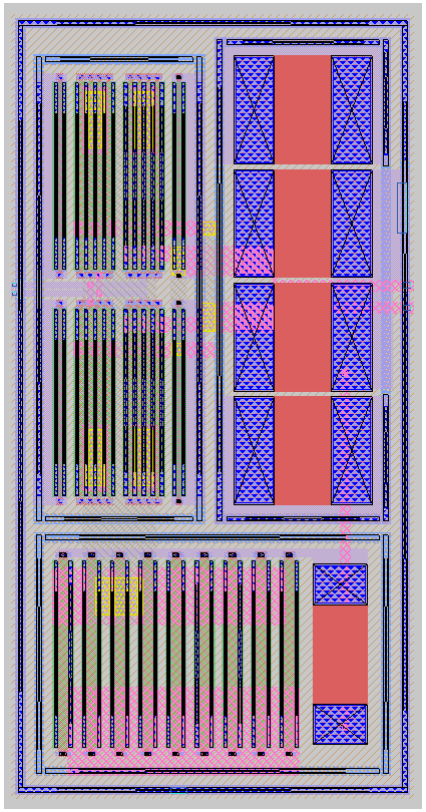
[picture p12: figure]

Figure 10: The signed-off bomu cell in magic (SKY130A): the common-centroid W = 80µm pair with edge dummies, the dummy-flanked res high po load bank, and the interdigitated tail mirror, each wrapped in a VSS-tied p⁺ guard ring.

Verification and sign-off. The block closes LVS (netgen against ip/bomu.sch) match uniquely, and both DRC decks — magic geometric and the klayout sky130A mr sign-off runset on the written GDS — report zero violations. Parasitics are then extracted (full R+C RCX via magic’s extresist) and the tt AC response re-run against the extracted netlist. Table 11 compares the schematic and post-layout operating point: as Section 8.7 anticipated, the parasitics load the output pole (a few-percent bandwidth shave) but leave the DC gain essentially untouched, and the ∼ 12% pre-layout bandwidth margin absorbs the shift — the extracted design still clears both the 10dB gain and 150MHz bandwidth targets.

Table 11: Adopted W = 80µm design: schematic vs. post-layout (RCX, full R + C) at the tt corner, 27◦C, VDD = 1.20V . Both specs (Av0 ≥ 10dB, f−3dB ≥ 150MHz) are met with parasitics.
Quantity | Schematic | Post-layout (RCX) | Unit
Differential gain Av0 | 10.1 | 10.19 | dB
Bandwidth f−3dB | 168 | 164.1 | MHz

The signed-off GDS and the LVS/DRC reports are archived under tapeout/ and verify/; the extraction and compare scripts are verify/ext rcx.tcl, verify/run lvs.sh and verify/drc.sh, and the post-layout corner sweep is sim/corners.py pex rcx.

## 12 Status and Next Steps

The sign-off cockpit for the adopted W = 80µm design — the block intended for tapeout — is collected below as a single-glance review summary of the targets, the tt performance (schematic and post-layout RCX), the small-signal quality and the physical-verification status. Every number is carried elsewhere in the document; this is the consolidated view. All performance figures are at the tt corner, VDD = 1.20V , 27◦C; the quality figures are on the extracted netlist (verify/bomu rcx.spice). The offset/CMR-R/PSRR figures come from sky130A native local device-mismatch Monte Carlo only — not a global process-corner MC, so they are a matching check, not a full statistical sign-off.

| Performance (tt; schematic → post-layout RCX). Differential DC gain Av0 = 10.1 → 10.19 dB (target ≥ 10 dB, ✓); bandwidth f−3dB = 168 → 164.1 MHz (target ≥ 150 MHz, ✓); output swing 400 mVpp at 0.61% THD (target 400 mVpp, ✓); power P = VDDItail = 2.74 mW (Itail = 2.28 mA).
| Operating point (ip/bomu.sch). Input pair M1, M2: nfet 01v8 lvt W=80µm/L=0.15/nf=8; drain loads RD: res high po ≈ 243 Ω; tail mirror N=8 at VSC = 1.052 V, Vtail = 0.333 V; inversion gm/ID = 15 V⁻¹ .
| Small-signal quality (RCX; native local device-mismatch MC). Input offset σ(Vos) ≈ 2.8 mV and 3σ(Vos) ≈ 8.3 mV (40-draw); CMRR ≈ 67 dB and PSRR ≈ 53 dB (differential, median of 24 draws); input-referred noise ≈ 93 µVrms (10Hz–1GHz).
| Physical verification. LVS (netgen) matches uniquely (✓); DRC zero violations on both the magic and klayout sky130A mr decks (✓); parasitics extracted full R+C RCX (✓).

The central result (Section 8) is that the 10dB / 150MHz specification sits on the single-stage gain– bandwidth wall gm/(2πCL), which the baseline sizing clears by only ∼ 1.5%. A small gm increase and a parasitic margin give the adopted W = 80µm design (RD ≈ 245Ω, Itail = 2.28mA, 2.74mW), which meets both targets at the tt corner — Av0 = 10.1dB, f−3dB = 168MHz, 400mVpp swing at 0.61% THD — and survives the native local device-mismatch MC (Section 10), which moves offset; the differential gain and bandwidth are expected to be left essentially unchanged by mismatch, since the common-mode and mismatch terms cancel in a balanced pair — though the draws were scored for offset and CMRR/PSRR, not for a gain/BW spread, so this is an expectation rather than a measured σ(Av0)/σ(f−3dB). This MC covers per-device mismatch only; it is not a global process-corner Monte Carlo, so it is not a full statistical sign-off — a global process-corner MC (with the full VDD/temperature grid) remains a future step. On the area–power plane (Sections 8.3–8.4) it sits near the joint minimum of area and power the tt criteria allow, on the gm/ID = 15 ray that is the optimum of a power-weighted cost.
The physical implementation (Section 11) is now complete and signed off: the W = 80µm common-centroid pair, the dummy-flanked load bank and the interdigitated tail mirror are drawn with VSS-tied guard rings, the block closes netgen LVS match uniquely and passes both the magic and klayout sky130A mr DRC decks with zero violations, and the extracted-parasitic (RCX) tt AC re-simulation confirms the ∼ 12% bandwidth margin absorbs the parasitic pole shift with the gain intact (Table 11). The signed-off GDS and reports are archived under tapeout/ and verify/.
The offset/CMRR/PSRR/noise characterisation of Section 10 is now run directly on the extracted (post-layout) netlist: the native device-mismatch Monte Carlo and the CMRR/PSRR/noise measurements all exercise verify/bomu rcx.spice, so they carry both the adopted W=80µm sizing and the layout parasitics. The headline differential gain/bandwidth are expected to be essentially untouched by mismatch (balanced-pair cancellation; the draws were not scored for their spread); the quality metrics land at σ(Vos) ≈ 2.8mV , CMRR ≈ 67dB, PSRR ≈ 53dB and ≈ 93µVrms input-referred noise, with the supply-rejection path the most parasitic-sensitive (Asc rising from the ideal RD-coupling estimate once the extracted VDD-to-drain capacitors are included).

Further improvements. Several directions would push the design past its current limits. (i) The headline constraint is the single-stage gain–bandwidth wall gm/(2πCL) (Section 8), and the analysis there is explicit that the only lever on that wall is more gm — bought either by spending more power (moving up a gm/ID ray) or by raising the gm/ID efficiency itself (a steeper ray, bounded above by the swing/headroom walls of Section 8.2). At fixed gain and swing the bandwidth scales linearly with power at a slope set by that gm/ID efficiency (Eq. (9)), and no load re-tuning escapes the 474MHz ideal product (Eq. (8), Table 5). Cascoding to raise ro would only slide the design along that hyperbola — more gain for less bandwidth — and still miss both targets at the baseline gm, so it is not a way around the wall. What a cascode can do, applied to the input pair rather than the load, is reduce the Miller multiplication of Cgd that forms the second-order gate pole — the pole Section 8.5 found pulls the realised GBW ∼ 1.5% below the 474MHz ideal. An input-pair cascode could recover part of that 1.5%, nudging the realised product toward the single-pole ideal rather than beating it, at the cost of the extra stacked VDS,sat the 1.2V rail and 400mVpp swing make scarce. (ii) Active-inductor peaking at the output pole would extend f−3dB at fixed RD and current; a passive spiral of the required value is far too large for the TinyTapeout tile, so only an active inductor (a gyrator-C load) is practical, buying bandwidth margin at the price of its own headroom and noise. (iii) The supply-rejection path is the weakest small-signal link (Asc = −7.8dB, Section 10, set by VDD coupling through RD onto the drains); a replica-biased or regulated drain load would attenuate that path and tighten the present PSRR ≈ 53dB (median of the 24-draw native-mismatch set). (iv) The simple tail mirror is compliance-limited (Section 8.8); a lowvoltage cascode or constant-gm tail would raise the tail output resistance — improving on the present CMRR ≈ 67dB (24-draw median) — and cut the supply/temperature sensitivity of Itail, if the 200mV budget can be relaxed or a cascode fitted within it. (v) If offset ever becomes a spec, chopping or auto-zeroing (or simply more pair area) would push below the present σ(Vos) ≈ 2.8mV (40-draw native-mismatch MC). None of these beats the gain–bandwidth wall — Section 8 shows only more gm per mW does that; they refine the realised design toward its ideal limit (input cascode), extend bandwidth (active inductor), or harden the rejection and offset the quality section measures.

## References

[1] P. G. A. Jespers and B. Murmann, Systematic Design of Analog CMOS Circuits Using Pre-Computed Lookup Tables. Cambridge University Press, 2017.
[2] B. Razavi, Design of Analog CMOS Integrated Circuits, 2nd ed. McGraw-Hill, 2017, ch. 4: Differential Amplifiers.
