Mthanson1/bomu-ieee-sscs/docs/Figures/bomu_sweep_L.png

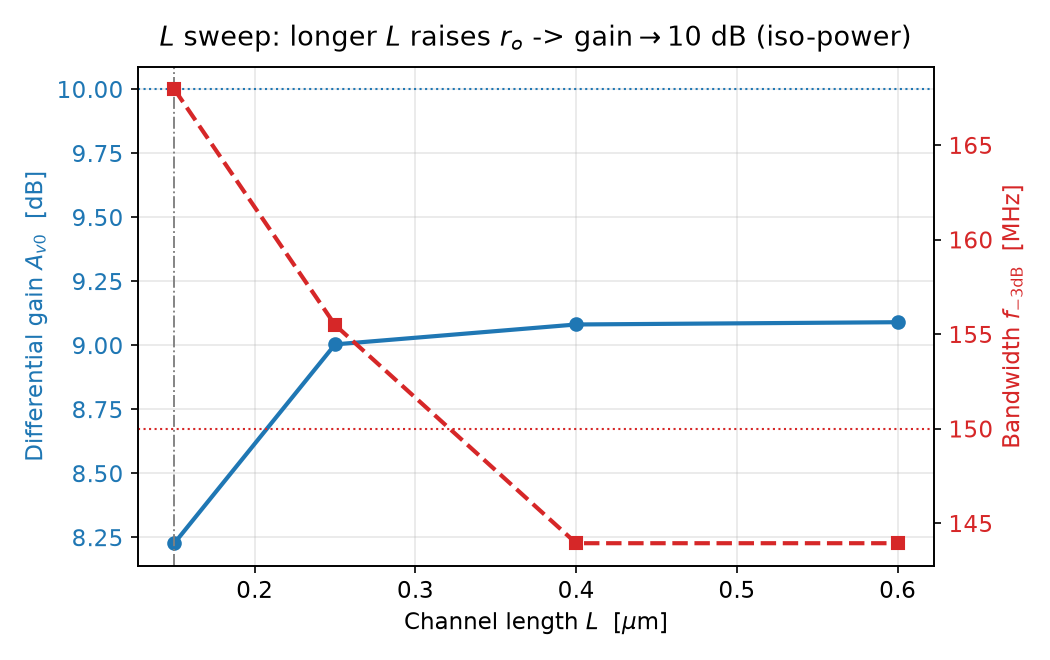
docs/Figures/bomu_sweep_L.png
