Mthanson1/bomu-ieee-sscs/(commit log)

2026-08-28 ip: xschem schematic, symbol, swing testbench
2026-10-29 Resize to tt corner (W=80um) (#1)
    * Adopt the W=80/nf=8 pair sizing with retuned load and bias resistors in the schematic.
    * Swap in the signed-off common-centroid W=80 magic layout and its extracted netlist.
    * Remove the orphaned nfet device cells no longer referenced by the layout.
    * Keep the W=320 PVT-robust layout as an alternate cell.
    * Regenerate the extraction/LVS decks and LVS report for the W=80 layout.
    * Refresh the signed-off GDS and update the signoff checksum and date.
    * Add the area-power and gain-space design-space plotting scripts.
    * Extend corners.py and sizing.py with the PEX corner sweep, mismatch MC and design-cockpit table.
    * Update the swing testbench and its ne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
